FranMald/Proyecto-Final-luminarias/Placa tesis 3d.png

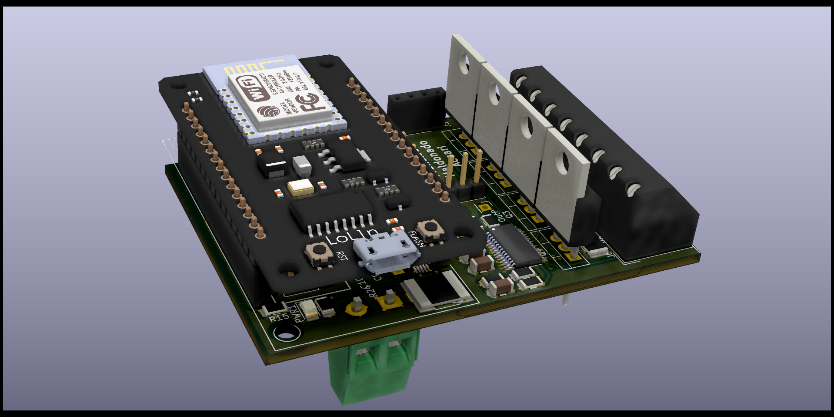
Placa tesis 3d.png
