FranMald/Proyecto-Final-luminarias/README.MD

Prueba de archivo readme sadfasdasd
prueba commit
