FranMald/Proyecto-Final-luminarias/Placa/LM3464/IC_TPS61196PWPRQ1/IC_TPS61196PWPRQ1.step

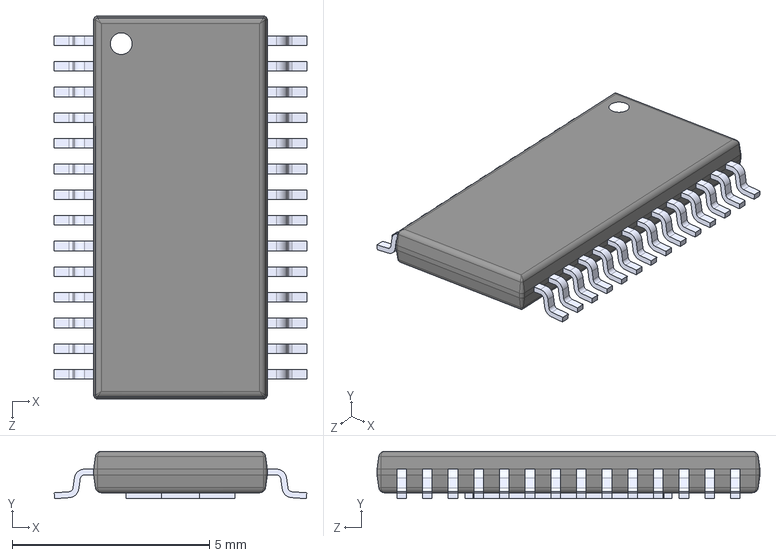
[picture p5: CAD file, 2024-04-25]
Placa/LM3464/IC_TPS61196PWPRQ1/IC_TPS61196PWPRQ1.step
6.40 x 1.20 x 9.70 mm
