FranMald/Proyecto-Final-luminarias/Aplicacion Godot/thingsboardtest/Test.txt

{"id":{"entityType":"DEVICE_PROFILE","id":"04819920-bd8e-11eb-a311-cf80d7127bfd"},"createdTime":1621970322354,"tenantId":{"entityType":"TENANT","id":"7b3f3370-bd8d-11eb-a311-cf80d7127bfd"},"name":"Luminaria","description":null,"image":null,"type":"DEFAULT","transportType":"MQTT","provisionType":"ALLOW_CREATE_NEW_DEVICES","defaultRuleChainId":null,"defaultDashboardId":null,"defaultQueueName":null,"provisionDeviceKey":"444oijxepojfgh3n0oag","firmwareId":null,"softwareId":null,"defaultEdgeRuleChainId":null,"externalId":null,"default":true,"profileData":{"configuration":{"type":"DEFAULT"},"transportConfiguration":{"type":"MQTT","deviceTelemetryTopic":"v1/devices/me/telemetry","deviceAttributesTopic":"v1/devices/me/attributes","deviceAttributesSubscribeTopic":"v1/devices/me/attributes","transportPayloadTypeConfiguration":{"transportPayloadType":"JSON"},"sparkplug":false,"sparkplugAttributesMetricNames":null,"sendAckOnValidationException":false},"provisionConfiguration":{"type":"ALLOW_CREATE_NEW_DEVICES","provisionDeviceSecret":"2peqabgnq5zkfyucnrp5"},"alarms":[{"id":"e782b073-fcd1-73cb-2063-5a17a5baba93","alarmType":"Hi TEMP","createRules":{"MINOR":{"condition":{"condition":[{"key":{"type":"TIME_SERIES","key":"TEMP"},"valueType":"NUMERIC","value":null,"predicate":{"type":"NUMERIC","operation":"GREATER","value":{"defaultValue":40.0,"userValue":null,"dynamicValue":null}}}],"spec":{"type":"SIMPLE"}},"schedule":null,"alarmDetails":null,"dashboardId":{"entityType":"DASHBOARD","id":"3a310a70-c265-11eb-be9f-e16ea861b384"}}},"clearRule":null,"propagate":false,"propagateToOwner":false,"propagateToTenant":false,"propagateRelationTypes":null},{"id":"b6151108-1ca7-734a-ee2d-e213886363bd","alarmType":"luz","createRules":{"CRITICAL":{"condition":{"condition":[{"key":{"type":"TIME_SERIES","key":"LUM1"},"valueType":"NUMERIC","value":null,"predicate":{"type":"NUMERIC","operation":"LESS","value":{"defaultValue":2000.0,"userValue":null,"dynamicValue":null}}},{"key":{"type":"ATTRIBUTE","key":"PWM"},"valueType":"NUMERIC","value":null,"predicate":{"type":"NUMERIC","operation":"NOT_EQUAL","value":{"defaultValue":0.0,"userValue":null,"dynamicValue":null}}}],"spec":{"type":"SIMPLE"}},"schedule":null,"alarmDetails":null,"dashboardId":{"entityType":"DASHBOARD","id":"3a310a70-c265-11eb-be9f-e16ea861b384"}}},"clearRule":null,"propagate":false,"propagateToOwner":false,"propagateToTenant":false,"propagateRelationTypes":null},{"id":"c8737cde-a9a0-2dfa-b4d8-031023fcb4ba","alarmType":"HI HUM","createRules":{"MAJOR":{"condition":{"condition":[{"key":{"type":"TIME_SERIES","key":"HUM"},"valueType":"NUMERIC","value":null,"predicate":{"type":"NUMERIC","operation":"GREATER","value":{"defaultValue":80.0,"userValue":null,"dynamicValue":null}}}],"spec":{"type":"SIMPLE"}},"schedule":null,"alarmDetails":null,"dashboardId":{"entityType":"DASHBOARD","id":"3a310a70-c265-11eb-be9f-e16ea861b384"}}},"clearRule":null,"propagate":false,"propagateToOwner":false,"propagateToTenant":false,"propagateRelationTypes":null}]}}
