FranMald/Proyecto-Final-luminarias/Placa/Placa tesis.kicad_pcb

## KiCad design Placa/Placa tesis.kicad_pcb (2024-04-25)

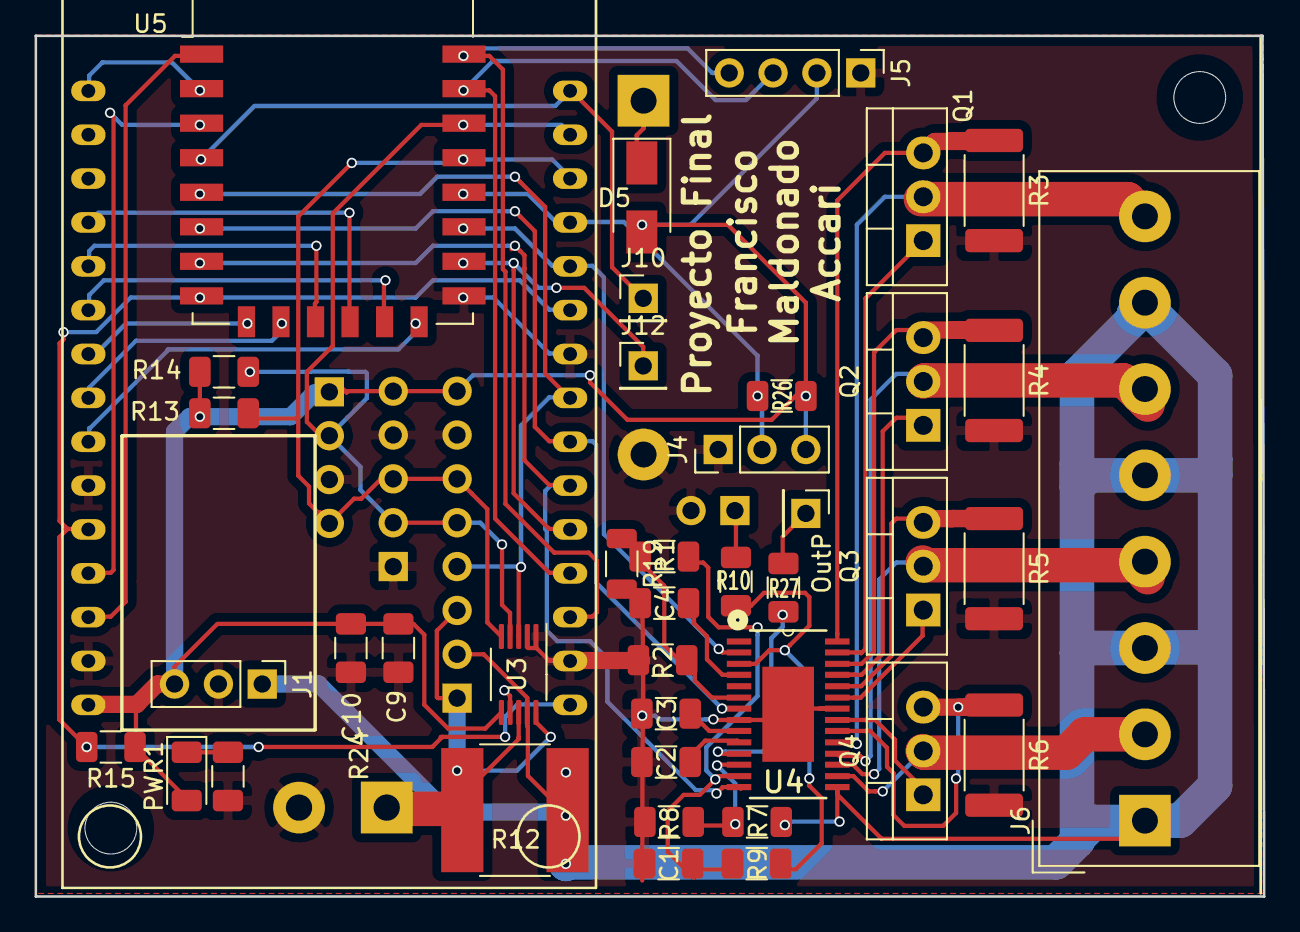
[picture p6: board Placa tesis.kicad_pcb from above]

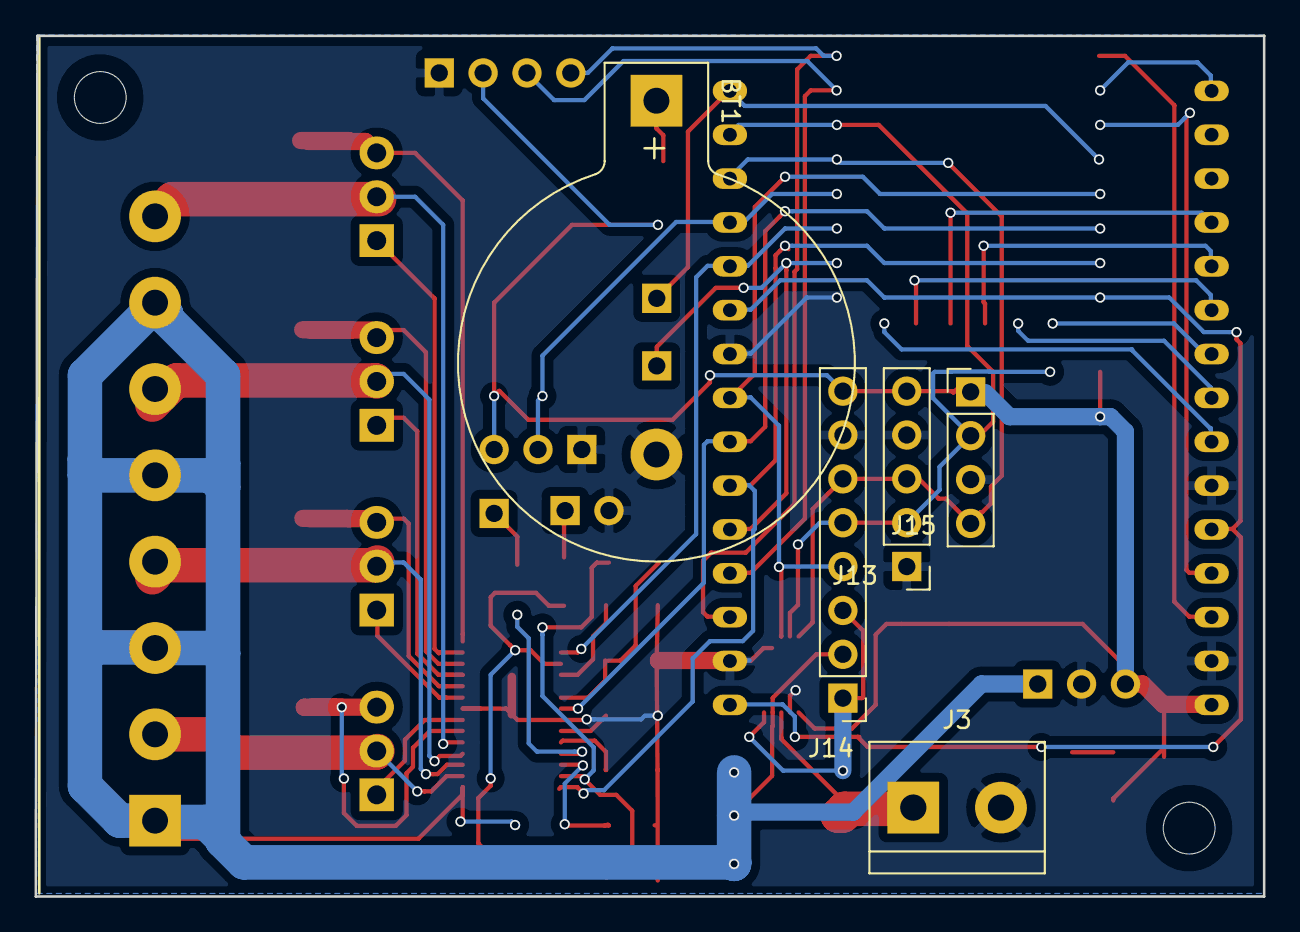
[picture p7: board Placa tesis.kicad_pcb from below]

Board: 2 copper layers, 71.1 x 49.9 mm, 47 parts (5 on the bottom side), 48 nets.

Parts:
BT1: Battery_Cell; BatteryHolder_Keystone_103_1x20mm
C1, C2, C4: 1u; C_1206_3216Metric
C3: 2.2n; C_1206_3216Metric
C9: 4.7u; C_1206_3216Metric
C10: 100n; C_1206_3216Metric
D5: DIODE; D_SMA
J1: OKI-78SR; Pin_Header_Straight_1x03_Pitch2.54mm
J3: FUENTE; TerminalBlock_bornier-2_P5.08mm
J4: DHT11; PinHeader_1x03_P2.54mm_Vertical
J5: COMM; PinHeader_1x04_P2.54mm_Vertical
J6: Conn_01x08; Altech_AK300_1x08_P5.00mm_45-Degree
J10, J12: Conn_01x01; PinHeader_1x01_P2.54mm_Vertical
J13: BH1750; PinHeader_1x05_P2.54mm_Vertical
J14: INA226; PinHeader_1x08_P2.54mm_Vertical
J15: Conn_01x04; PinHeader_1x04_P2.54mm_Vertical
OutP: Pin_Header_Straight_1x01_Pitch2.54mm
PWR1: LED; LED_1206_3216Metric
Q1, Q2, Q3, Q4: Q_NMOS_GDS; TO-220-3_Vertical
R1, R7, R19: 10k; R_1206_3216Metric
R2, R26: 4.7k; R_1206_3216Metric
R3, R4, R5, R6: 0.2; R_2512_6332Metric
R8: 1.5k; R_1206_3216Metric
R9, R10, R27: R; R_1206_3216Metric
R12: 270; R_2816
R13, R14: 10K; R_1206_3216Metric
R15: 0.001; R_1206_3216Metric
R24: 270; R_1206_3216Metric
TH1: Thermistor_NTC; Pin_Header_Angled_1x02_Pitch2.54mm
U2: Nodemcuv_3; DIP-30_1098_ELL
U3: INA226; VSSOP-10_3x3mm_P0.5mm
U4: LM3464AMH_NOPB; SOP65P640X110-29N
U5: ESP-12E

Connections:
A0: U2.1, U5.2
ALARM: J14.4, U2.23, U3.3, U5.5
D0: J10.1, U2.30, U5.4
D1: J13.2, J14.5, J15.2, R14.1, U2.29, U3.4, U5.20
D2: J13.3, J14.6, J15.4, R13.1, U2.28, U3.5, U5.19
D3: J4.2, R26.2, U2.27, U5.18
D4: U2.26, U4.2, U5.17
D6: U2.22, U4.7, U5.6
D7: U2.21, U4.14, U5.7
D8: J12.1, R19.1, U2.20, U5.16
DR1: J6.8, Q1.2, U4.19
DR2: J6.6, Q2.2, U4.18
DR3: J6.4, Q3.2, U4.17
DR4: J6.2, Q4.2, U4.16
EN_esp: U2.12, U5.3
GD1: Q1.1, U4.27
GD2: Q2.1, U4.25
GD3: Q3.1, U4.23
GD4: Q4.1, U4.21
GND: BT1.2, C1.2, C2.2, C3.2, C4.2, C9.2, C10.2, J1.2, J3.2, J4.1, J5.1, J13.1, J13.4, J14.7, J15.3, R2.2, R3.2, R4.2, R5.2, R6.2, R8.2, R19.2, R24.1, TH1.2, U2.10, U2.14, U2.17, U2.24, U3.1, U3.2, U3.7, U4.8, U4.22, U5.15
unnamed: BT1.1, D5.1
unnamed: C2.1, U4.10
unnamed: C3.1, U4.9
unnamed: C4.1, U4.4
unnamed: PWR1.1, R24.2
unnamed: R1.2, R2.1, U4.6
unnamed: R7.2, R8.1, U4.12
unnamed: R9.2, R10.1, U4.3
unnamed: R27.2, U4.11
OutP: OutP.1, R27.1
RST_esp: U2.13, U5.1
RX: J5.3, U2.19, U5.21
S0: U2.8, U5.10
S1: U2.6, U5.13
S2: U2.5, U5.11
S3: U2.4, U5.12
SC: U2.7, U5.9
SE1: Q1.3, R3.1, U4.28
SE2: Q2.3, R4.1, U4.26
SE3: Q3.3, R5.1, U4.24
SE4: Q4.3, R6.1, U4.20
SK: U2.9, U5.14
THR: R10.2, TH1.1
TX: J5.4, U2.18, U5.22
V5: C9.1, C10.1, D5.2, J1.3, J4.3, J5.2, J13.5, J14.8, J15.1, PWR1.2, R13.2, R14.2, R15.1, R15.2, R26.1, U2.11, U2.15, U2.16, U2.25, U3.6, U5.8
VccLED: C1.1, R1.1, R9.1, U4.13
Vin: J1.1, J6.1, J6.3, J6.5, J6.7, J14.2, R7.1, R12.1, U3.9, U4.15
VinS: J3.1, J14.1, J14.3, R12.2, U3.8, U3.10
