FranMald/Proyecto-Final-luminarias/Placa/Prueba_placa2.kicad_pcb

## KiCad design Placa/Prueba_placa2.kicad_pcb (2020-10-28)

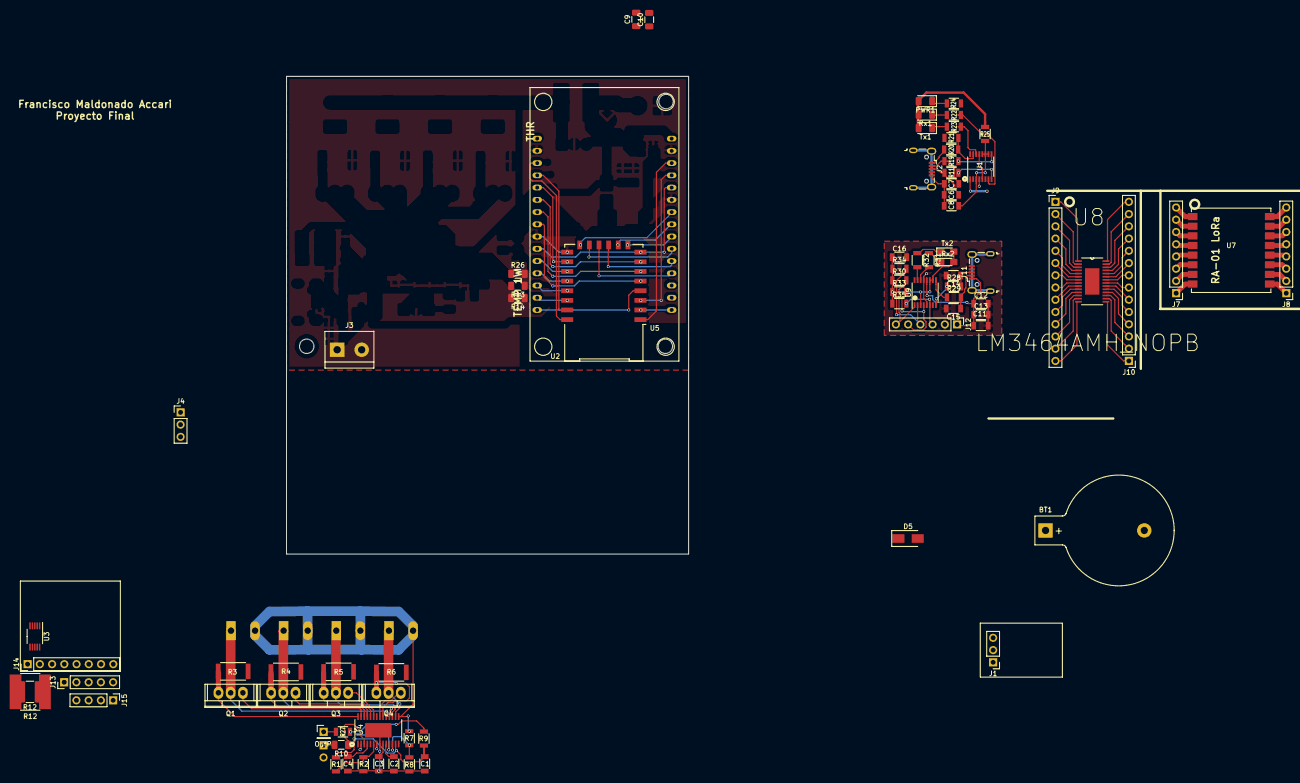
[picture p8: board Prueba_placa2.kicad_pcb from above]

Board: 2 copper layers, 85 parts (0 on the bottom side), 119 nets.

Parts:
BT1: Battery_Cell; BatteryHolder_Keystone_103_1x20mm
C1, C13: 10n; C_1206
C2, C3, C4: C; C_1206
C6, C7, C14, C15: 47p; C_1206
C8, C12, C16: 100n; C_1206
C9: 4.7u; C_1206_3216Metric
C10: 100n; C_1206_3216Metric
C11: 4.7u; C_1206
D1, D2, D4: LED; TerminalBlock_Altech_AK300-2_P5.00mm
D3: LED; TerminalBlock_Altech_AK300-2_P5.00mmnosilk
D5: DIODE; D_SMA
J1: Conn_01x03; Pin_Header_Straight_1x03_Pitch2.54mm
J2, J11: USB_B_Micro; USB_Micro-B_Wuerth-629105150521
J3: Conn_01x02; TerminalBlock_bornier-2_P5.08mm
J4: Conn_01x03; PinHeader_1x03_P2.54mm_Vertical
J7, J8: Conn_01x08; Pin_Header_Straight_1x08_Pitch2.54mm
J9, J10: Conn_01x14; Pin_Header_Straight_1x14_Pitch2.54mm
J12: Conn_01x06; Pin_Header_Straight_1x06_Pitch2.54mm
J13: Conn_01x05; PinHeader_1x05_P2.54mm_Vertical
J14: Conn_01x08; PinHeader_1x08_P2.54mm_Vertical
J15: Conn_01x04; PinHeader_1x04_P2.54mm_Vertical
OutP: Pin_Header_Straight_1x01_Pitch2.54mm
PWR1: LED; LED_1206_3216Metric
Q1, Q2, Q3, Q4: Q_NMOS_GDS; TO-220
R1, R2, R7, R8, R9, R27: R; R_1206
R3, R4, R5, R6: 0.2; R_2512
R10: R; R_1206_3216Metric
R11, R19, R28, R29: 27; R_1206
R12: 7.5m; R_2816
R12#2: 270; R_2816_7142Metric
R13, R14: 10K; R_1206_3216Metric
R20: 4.7k; R_1206
R21: 10k; R_1206
R22, R23, R24, R31, R32: 270; R_1206
R25: .1; R_1206
R26: 4.7k; R_1206_3216Metric
R30, R33, R34, R35: 10K; R_1206
Rx1: LED; LED_1206_3216Metric
Rx2: LED; LED_0805_HandSoldering
TH1: Thermistor_NTC; Pin_Header_Angled_1x02_Pitch2.54mm
Tx1: LED; LED_1206_3216Metric
Tx2: LED; LED_0805_HandSoldering
U1, U9: FT230XS; SSOP-16_3.9x4.9mm_Pitch0.635mm
U2: Nodemcuv_3; DIP-30_1098_ELL
U3: INA226; VSSOP-10_3x3mm_P0.5mm
U4, U8: LM3464AMH_NOPB; SOP65P640X110-29N
U5: ESP-12E
U7: Ra-01-LoRa; Ai-Thinker-Ra-01-LoRa

Connections:
A0: U2.1, U5.2
ALARM: J14.4, U2.23, U3.3, U5.5
D0: U2.30, U5.4
D1: J13.2, J14.5, J15.2, R14.1, U2.29, U3.4, U5.20
D2: J13.3, J14.6, J15.4, R13.1, U2.28, U3.5, U5.19
D3: J4.2, R26.2, U2.27, U5.18
D4: U2.26, U4.2, U5.17
D6: U2.22, U4.7, U5.6
D7: U2.21, U4.14, U5.7
D8: U2.20, U5.16
DR1: D1.1, Q1.2, U4.19
DR2: D2.1, Q2.2, U4.18
DR3: D3.1, Q3.2, U4.17
DR4: D4.1, Q4.2, U4.16
EN_esp: U2.12, U5.3
GD1: Q1.1, U4.27
GD2: Q2.1, U4.25
GD3: Q3.1, U4.23
GD4: Q4.1, U4.21
GND: BT1.2, C1.2, C2.2, C3.2, C4.2, C6.2, C7.2, C8.2, C9.2, C10.2, J1.2, J2.5, J3.1, J4.1, J13.1, J13.4, J14.7, J15.3, R2.2, R3.2, R4.2, R5.2, R6.2, R8.2, R21.2, R24.1, TH1.2, U1.5, U1.13, U2.10, U2.14, U2.17, U2.24, U3.1, U3.2, U3.7, U4.8, U4.22, U5.15
GND2: C11.2, C12.2, C13.2, C14.2, C15.2, C16.2, J11.5, J12.2, U9.5, U9.13
unnamed: BT1.1, D5.1
unnamed: C2.1, U4.10
unnamed: C3.1, U4.9
unnamed: C4.1, U4.4
unnamed: C6.1, J2.3, R11.2
unnamed: C7.1, J2.2, R19.2
unnamed: C8.1, R25.1, U1.3, U1.10, U1.11, U1.12
unnamed: C11.1, C12.1, C13.1, J11.1, J12.1, U9.12
unnamed: C14.1, J11.3, R28.2
unnamed: C15.1, J11.2, R29.2
unnamed: C16.1, R30.1, R33.1, R34.1, R35.1, Rx2.2, Tx2.2, U9.3, U9.10, U9.11
unnamed: J2.1, R20.1
unnamed: J7.1, U7.8
unnamed: J7.2, U7.7
unnamed: J7.3, U7.6
unnamed: J7.4, U7.5
unnamed: J7.5, U7.4
unnamed: J7.6, U7.3
unnamed: J7.7, U7.2
unnamed: J7.8, U7.1
unnamed: J8.1, U7.9
unnamed: J8.2, U7.10
unnamed: J8.3, U7.11
unnamed: J8.4, U7.12
unnamed: J8.5, U7.13
unnamed: J8.6, U7.14
unnamed: J8.7, U7.15
unnamed: J8.8, U7.16
unnamed: J9.1, U8.1
unnamed: J9.2, U8.2
unnamed: J9.3, U8.3
unnamed: J9.4, U8.4
unnamed: J9.5, U8.5
unnamed: J9.6, U8.6
unnamed: J9.7, U8.7
unnamed: J9.8, U8.8
unnamed: J9.9, U8.9
unnamed: J9.10, U8.10
unnamed: J9.11, U8.11
unnamed: J9.12, U8.12
unnamed: J9.13, U8.13
unnamed: J9.14, U8.14
unnamed: J10.1, U8.15
unnamed: J10.2, U8.16
unnamed: J10.3, U8.17
unnamed: J10.4, U8.18
unnamed: J10.5, U8.19
unnamed: J10.6, U8.20
unnamed: J10.7, U8.21
unnamed: J10.8, U8.22
unnamed: J10.9, U8.23
unnamed: J10.10, U8.24
unnamed: J10.11, U8.25
unnamed: J10.12, U8.26
unnamed: J10.13, U8.27
unnamed: J10.14, U8.28
unnamed: J12.3, R35.2, U9.6
unnamed: J12.4, R34.2, U9.2
unnamed: J12.5, R33.2, U9.4
unnamed: J12.6, R30.2, U9.1
unnamed: PWR1.1, R24.2
unnamed: R1.2, R2.1, U4.6
unnamed: R7.2, R8.1, U4.12
unnamed: R9.2, R10.1, U4.3
unnamed: R10.2, TH1.1
unnamed: R11.1, U1.8
unnamed: R19.1, U1.9
unnamed: R20.2, R21.1, U1.15
unnamed: R22.1, Rx1.1
unnamed: R22.2, U1.7
unnamed: R23.1, Tx1.1
unnamed: R23.2, U1.14
unnamed: R27.2, U4.11
unnamed: R28.1, U9.8
unnamed: R29.1, U9.9
unnamed: R31.1, Rx2.1
unnamed: R31.2, U9.14
unnamed: R32.1, Tx2.1
unnamed: R32.2, U9.15
unnamed: U2.11, U2.16, U2.25, U5.8
OutP: OutP.1, R27.1
RST_esp: U2.13, U5.1
RX: U1.1, U2.19, U5.21
S0: U2.8, U5.10
S1: U2.6, U5.13
S2: U2.5, U5.11
S3: U2.4, U5.12
SC: U2.7, U5.9
SE1: Q1.3, R3.1, U4.28
SE2: Q2.3, R4.1, U4.26
SE3: Q3.3, R5.1, U4.24
SE4: Q4.3, R6.1, U4.20
SK: U2.9, U5.14
TX: U1.4, U2.18, U5.22
V5: C9.1, C10.1, D5.2, J1.3, J4.3, J13.5, J14.8, J15.1, PWR1.2, R13.2, R14.2, R25.2, R26.1, Rx1.2, Tx1.2, U2.15, U3.6
VccLED: C1.1, R1.1, R9.1, U4.13
Vin: D1.2, D2.2, D3.2, D4.2, J1.1, J14.2, R7.1, R12.1, R12#2.1, U3.9, U4.15
VinS: J3.2, J14.1, J14.3, R12.2, R12#2.2, U3.8, U3.10
