FranMald/Proyecto-Final-luminarias/Firmware/Config.txt

{"mqtt_pword": "",
"Scan Rate": "5000",
"wifi_ssid": "DAVITELWIFI34778",
"Light status": "off",
"mqtt_url": "demo.thingsboard.io",
"wifi_pword": "Ja5Achoh","id": "3",
"Muestras_AVG": "100",
"Scan status": "on",
"mqtt_user": "QKNc5TFgtJLQiy9lnQNa", 
"PID_state":"on", 
"PWM": "391"}
