FranMald/Proyecto-Final-luminarias/(commit log)

2020-10-28 Commit de prueba
2020-10-28 Commit de prueba 2
2020-10-28 quitè el IDE
2020-10-28 agregada la placa al repo
    [Placa tesis-B.Cu.gbr, Placa tesis-B.Mask.gbr, Placa tesis-B.Paste.gbr, Placa tesis-B.SilkS.gbr, Placa tesis-B_Cu.gbr, Placa tesis-B_Mask.gbr, Placa tesis-B_SilkS.gbr, Placa tesis-Eco2_User.gbr]
2020-10-28 limpieza de la carpeta de placa
    [Placa tesis-B.Cu.gbr, Placa tesis-B.Mask.gbr, Placa tesis-B.Paste.gbr, Placa tesis-B.SilkS.gbr, Placa tesis-B_Cu.gbr, Placa tesis-B_Mask.gbr, Placa tesis-B_SilkS.gbr, Placa tesis-Edge.Cuts.gbr]
2020-10-28 agregada lectura de sensor de corriente
2021-05-16 actualicacion despes de mucho
    [Config.txt]
2021-05-19 Webserver funcionando
    [Config.txt]
2021-10-13 prueba de script
    [Config.txt]
2022-03-02 Agregado de aplicacion Godot
2022-03-25 archivos de configuracion
2022-05-11 diagrams de flujo
2022-05-12 diagrama de flujo
2022-05-12 Diagramas de flujo
2022-05-17 diagrama de flujo terminado
2022-06-02 diagramas de flujo terminados
2024-04-25 La venganza
    [Config.txt, IC_TPS61196PWPRQ1.step, LM3464MH.STEP, Placa tesis.kicad_pcb]
